rsampson/SimpleSonar/hardware/sonar_preamp/sonar_preamp.csv

Reference | Qty | Value | DNP | Exclude from BOM | Exclude from Board | Exclude from Simulation | Exclude from Position Files | Footprint | Datasheet
C1,C2,C3 | 3 | .5 uf |  |  |  |  | ${EXCLUDE_FROM_POS_FILES}
C4,C5 | 2 | 10 uf |  |  |  |  | ${EXCLUDE_FROM_POS_FILES}
MK1 | 1 | Microphone |  |  |  |  | ${EXCLUDE_FROM_POS_FILES}
R1 | 1 | 33k |  |  |  |  | ${EXCLUDE_FROM_POS_FILES}
R2,R3,R6 | 3 | 10k |  |  |  |  | ${EXCLUDE_FROM_POS_FILES}
R4,R5 | 2 | 1k |  |  |  |  | ${EXCLUDE_FROM_POS_FILES}
R7 | 1 | 2.2k |  |  |  |  | ${EXCLUDE_FROM_POS_FILES}
U1,U3 | 2 | TL081 |  |  |  |  | ${EXCLUDE_FROM_POS_FILES} |  | http://www.ti.com/lit/ds/symlink/tl081.pdf
U2 | 1 |  |  |  |  |  | ${EXCLUDE_FROM_POS_FILES} | ESP32_30pin
