rsampson/SimpleSonar/hardware/sonar_preamp/sonar_preamp.kicad_sch

## KiCad design hardware/sonar_preamp/sonar_preamp.kicad_sch (2026-10-12)

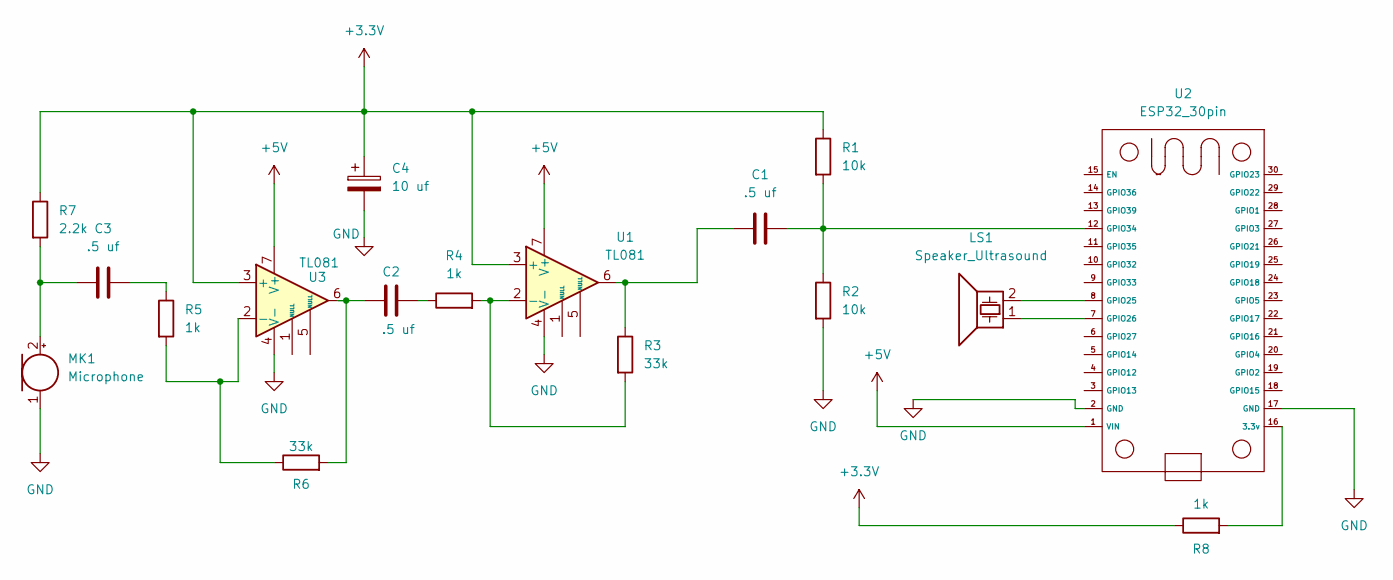
[picture p1: schematic sonar_preamp.kicad_sch]

Parts:
C1, C2, C3: .5 uf
C4: 10 uf
LS1: Speaker_Ultrasound
MK1: Microphone
R1, R2: 10k
R3, R6: 33k
R4, R5, R8: 1k
R7: 2.2k
U1, U3: TL081
U2: ESP32_30pin

Connections:
+3.3V: C4.1, R1.1, R7.1, R8.1, U1.3 (+), U3.3 (+)
+5V: U1.7 (V+), U2.1 (VIN), U3.7 (V+)
GND: C4.2, MK1.1 (-), R2.2, U1.4 (V-), U2.2 (GND), U2.17 (GND), U3.4 (V-)
unnamed: C1.1, R3.1, U1.6
unnamed: C1.2, R1.2, R2.1, U2.12 (GPIO34)
unnamed: C2.1, R6.2, U3.6
unnamed: C2.2, R4.1
unnamed: C3.1, MK1.2 (+), R7.2
unnamed: C3.2, R5.1
unnamed: LS1.1, U2.7 (GPIO26)
unnamed: LS1.2, U2.8 (GPIO25)
unnamed: R3.2, R4.2, U1.2 (-)
unnamed: R5.2, R6.1, U3.2 (-)
unnamed: R8.2, U2.16 (3.3v)
