rsampson/SimpleSonar/pc/plot_echogram.py

import argparse
import sys
import numpy as np
import matplotlib.pyplot as plt

import deconvolve
from plot_sensor_stream import load_packets, range_axis_cm
from plot_matched_filter import make_ping_template, matched_filter, US_TO_CM

INPUT_FILE = 'sensor_stream.csv'

# Below this (true, ping-start-relative) range the transmitted burst is
# still going out / ringing in the receiver
# (see make_ping_template's docstring) - the matched filter response there
# is dominated by the pulse's own autocorrelation sidelobes, not real
# echoes, so it's blanked out rather than shown as if it were a return.
MIN_DISPLAY_RANGE_CM = None  # set to a number to override the auto estimate

# Display in dB below the strongest echo in the whole recording. Larger
# values reveal more of the weak-echo/noise floor; smaller values show only
# strong returns.
DYNAMIC_RANGE_DB = 40

CM_PER_FOOT = 30.48


def hilbert_envelope(x):
    """Amplitude envelope of a real signal via the analytic signal.

    The matched-filter output oscillates at the ping's carrier frequency,
    so plotting it directly as color would just show the carrier's fringes
    rather than echo strength. The envelope (the magnitude of the analytic
    signal, i.e. |x + j*Hilbert(x)|) is the smooth quantity a real sonar
    display colorizes. This reimplements scipy.signal.hilbert's FFT method
    directly so the project doesn't need scipy as a dependency for one
    transform.
    """
    x = np.asarray(x, dtype=np.float64)
    n = len(x)
    spectrum = np.fft.fft(x)
    h = np.zeros(n)
    if n % 2 == 0:
        h[0] = h[n // 2] = 1.0
        h[1:n // 2] = 2.0
    else:
        h[0] = 1.0
        h[1:(n + 1) // 2] = 2.0
    analytic = np.fft.ifft(spectrum * h)
    return np.abs(analytic)


def build_echogram(packets):
    """Return (image [range x ping], range_cm, ping_times) for imshow."""
    n_samples = len(packets[0][1])
    sample_dt_us = packets[0][0]['SampleDt_us']
    range_cm = range_axis_cm(packets[0][0], n_samples)

    template = make_ping_template(sample_dt_us)
    burst_range_cm = len(template) * sample_dt_us * US_TO_CM
    blank_cm = MIN_DISPLAY_RANGE_CM if MIN_DISPLAY_RANGE_CM is not None else burst_range_cm
    # Samples captured before the burst ended; zero once the capture window
    # opens after the burst (the current firmware timing).
    blank_samples = int(np.searchsorted(range_cm, blank_cm))

    columns = []
    ping_times = []
    for meta, values in packets:
        tmpl = make_ping_template(meta['SampleDt_us'])
        if deconvolve.DECONV_ENABLED:
            resp = deconvolve.deconvolved_response(values, meta['SampleDt_us'],
                                                   template=tmpl,
                                                   domain=deconvolve.DECONV_DOMAIN)
        else:
            resp = matched_filter(values, tmpl)
        env = hilbert_envelope(resp)
        env[:blank_samples] = np.nan
        columns.append(env)
        ping_times.append(meta['T_ping_us'] / 1e6)  # seconds, ESP32 boot-relative

    image = np.column_stack(columns)  # shape: (n_samples, n_pings)
    return image, range_cm, np.array(ping_times), blank_cm


def to_db(image):
    finite = image[np.isfinite(image)]
    peak = finite.max() if finite.size else 1.0
    peak = peak if peak > 0 else 1.0
    with np.errstate(divide='ignore', invalid='ignore'):
        db = 20 * np.log10(image / peak)
    return db, peak


def main():
    parser = argparse.ArgumentParser()
    parser.add_argument('--deconv', dest='deconv', action='store_true',
                        help="Wiener-deconvolve the array ringdown out of each trace")
    parser.add_argument('--no-deconv', dest='deconv', action='store_false')
    parser.add_argument('--deconv-domain', choices=('mf', 'raw'),
                        default=deconvolve.DECONV_DOMAIN)
    parser.set_defaults(deconv=deconvolve.DECONV_ENABLED)
    args = parser.parse_args()
    deconvolve.DECONV_ENABLED = args.deconv
    deconvolve.DECONV_DOMAIN = args.deconv_domain

    packets = load_packets(INPUT_FILE)
    if not packets:
        print(f"No packets found in {INPUT_FILE}.")
        sys.exit(1)

    image, range_cm, ping_times_s, blank_cm = build_echogram(packets)
    db, peak = to_db(image)

    deconv_note = ""
    if deconvolve.DECONV_ENABLED:
        deconv_note = (f" (Wiener deconvolution ON, domain={deconvolve.DECONV_DOMAIN}, "
                       f"f0={deconvolve.RINGDOWN_FREQUENCY_HZ:.0f} Hz "
                       f"Q={deconvolve.RINGDOWN_Q:.0f} lambda={deconvolve.WIENER_LAMBDA:g})")
    print(f"Loaded {len(packets)} pings. Window covers {range_cm[0]:.1f}-{range_cm[-1]:.1f} cm; "
          f"blanking below {blank_cm:.1f} cm (transmit burst ringdown). "
          f"Peak envelope: {peak:.1f}{deconv_note}")

    t_rel = ping_times_s - ping_times_s[0]

    fig, ax = plt.subplots(figsize=(12, 6))
    mesh = ax.pcolormesh(
        t_rel, range_cm, db,
        shading='nearest',
        cmap='viridis',
        vmin=-DYNAMIC_RANGE_DB, vmax=0,
    )
    ax.invert_yaxis()  # fish-finder convention: shallow/near range at top
    ax.set_xlabel("Time since first ping (s)")
    ax.set_ylabel("Range (cm)")
    ax.set_title(f"Echogram — {len(packets)} pings, {DYNAMIC_RANGE_DB} dB dynamic range")

    ax_ft = ax.secondary_yaxis('right', functions=(lambda cm: cm / CM_PER_FOOT, lambda ft: ft * CM_PER_FOOT))
    ax_ft.set_ylabel("Range (ft)")

    cbar = fig.colorbar(mesh, ax=ax)
    cbar.set_label("Echo strength (dB re: strongest return)")

    fig.tight_layout()
    plt.show()


if __name__ == "__main__":
    main()
