rsampson/SimpleSonar/(commit log)

2026-08-19 Initial commit: ESP32 sonar firmware and PC tooling
    Firmware streams framed ping packets over UART; PC-side scripts record,
    inspect, and visualize them (raw waveform, matched filter, echogram).
2026-08-19 Merge Serial2 into Serial: single UART for data, debug, and commands
    Data packets, debug/status text, and START/STOP commands now all share
    one UART (previously data used a separate Serial2 on GPIO16/17).
    receive.py distinguishes binary packets from debug text by peeking at
    the leading sync bytes. Also makes run_pipeline.py pass --fresh to
    receive.py so each pipeline run starts a clean CSV instead of
    appending onto a prior session (mixing sessions was producing stale-
    looking artifacts in plot_echogram.py).
2026-08-19 Sample ADC via ESP-IDF continuous/DMA driver instead of analogRead()
    Replaces the analogRead()-in-a-loop sampling path (software-timed,
    ~25-40kHz, jittery per-sample spacing) with the ESP-IDF ADC continuous
    driver, giving hardware-clocked sampling at a fixed 100kHz
    (ADC_SAMPLE_FREQ_HZ). sample_dt_us in the packet header is now the
    nominal rate rather than a measured average.
    The original ESP32's ADC digital controller re-triggers conversions in
    hardware bursts rather than free-running, and each burst restart can
    emit a short run of spurious zero readings. repair_adc_glitches()
    linearly interpolates across these runs using real neighboring
    samples before a packet is sent, which eliminated th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
    [main.cpp]
2026-08-20 Drive the ping transducer with a stepped chirp instead of a fixed tone
    Sweeps the LEDC drive frequency across 5 discrete steps from 2640 Hz
    to 3960 Hz (+/-20% around the prior fixed 3300 Hz), holding each for
    4 cycles (20 cycles total, up from 10), instead of one constant-tone
    burst. Both differential channels are on separate LEDC timers, so
    each step reconfigures both back-to-back to keep the pair in sync.
    pc/plot_matched_filter.py's make_ping_template() is updated to
    reconstruct the same stepped-chirp waveform (each step starting at
    phase 0, matching ledcChangeFrequency()'s timer reconfiguration
    behavior) so the matched filter correlates against what was actually
    transmitted. Spreading th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
    [main.cpp, plot_matched_filter.py]
2026-08-20 Revert "Drive the ping transducer with a stepped chirp instead of a fixed tone"
    This reverts commit 0c6bb8fc692bc040991f950b3e650501c433df07.
    [main.cpp, plot_matched_filter.py]
2026-08-20 Shorten ping burst to 6 cycles for a narrowband transducer
    The transducer's measured Q (~14, ~250 Hz -3dB bandwidth around
    3500-3700 Hz) means it only needs ~4-5 cycles to reach steady drive
    amplitude, and being narrowband, a matched filter gets no meaningful
    compression from a longer single-tone burst anyway - the extra
    cycles only lengthen the near-field dead zone (echoes arriving
    before transmission finishes are unusable) for no resolution gain.
    [main.cpp, plot_matched_filter.py]
2026-08-20 Auto-detect the sonar's serial port instead of hardcoding it
    receive.py now probes /dev/ttyUSB0 and /dev/ttyUSB1 (whichever exist)
    for a device that responds to START like the sonar firmware, rather
    than requiring SERIAL_PORT to be hardcoded - useful since which port
    the ESP32 enumerates as changes depending on what else is plugged in.
    Set SERIAL_PORT to a specific path to force it and skip probing.
    Two related reliability issues turned up while building this and are
    fixed here too:
    - The read loop pulled bytes one at a time via ser.read(1), which
    can't reliably keep up with 921600 baud (measured OS receive-buffer
    backlog up to ~1952 bytes during a packet burst) and risked silent
    ker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
    [receive.py]
2026-08-21 Rename project to Simple Sonar
2026-08-21 Add live-updating echogram view alongside the offline plotting scripts
    Tails sensor_stream.csv as receive.py writes it and renders a scrolling
    matched-filter waterfall of the last 200 pings, so hardware tuning can be
    watched in real time instead of only after a recording finishes. Runs as
    a second process and never touches the serial port, reusing the existing
    matched-filter/envelope/parsing code from the offline scripts.
2026-08-21 Add a pytest suite and extract receive.py's packet parser for testability
    receive.py's packet-framing/resync logic previously lived inline inside
    the serial read loop, mixed with I/O, so it couldn't be tested without a
    real ESP32 attached. Pulls it into parse_next_event(), a standalone,
    behavior-preserving function (same console output and CSV rows as
    before) that takes a reader + small state dict and returns a tagged
    ParseResult, so tests can drive it with a fake in-memory reader instead.
    Adds pc/tests/ (pytest, config in pc/pyproject.toml) covering the
    extracted parser, BufferedReader, load_packets, plot_echogram_live's
    CSV-tailing logic, and the matched-filter/envelope math - the parts o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
2026-09-09 Add PC-side Wiener deconvolution to collapse transducer ringdown
    The 11-element voice-coil array now fitted resonates at ~2775 Hz with
    Q~47 (~60 Hz bandwidth) - much higher Q than the piezo it replaced - so
    each echo rings ~34 cycles and smears in range. A matched filter can't
    fix this (no bandwidth to compress).
    New pc/deconvolve.py: pure-numpy Wiener (regularized inverse) filter,
    cascaded after the matched filter. Divides out a synthetic damped-sinusoid
    model of the transducer impulse response, tuned by RINGDOWN_FREQUENCY_HZ /
    RINGDOWN_Q; WIENER_LAMBDA (0.03, picked by sweep) regularizes against
    noise/clutter amplification. domain='mf' (default) deconvolves the
    matched-filter output; 'raw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
2026-10-12 Switch to single-ended speaker/mic with stepped chirp; retune deconvolution; add preamp hardware, docs, and tooling
2026-10-14 Add signal-chain hardware characterization test plan
